TinyChipHub/bitaxe/(commit log)

2024-06-21 *Move barrel jack to fix the enclosure; *Add logo
    [bitaxeSupra-B_Cu.gbr, bitaxeSupra-B_Mask.gbr, bitaxeSupra-B_Paste.gbr, bitaxeSupra-B_Silkscreen.gbr, bitaxeSupra-Edge_Cuts.gbr, bitaxeSupra-F_Cu.gbr, bitaxeSupra-F_Mask.gbr, bitaxeSupra-F_Paste.gbr]
2024-07-15 Add TCH logo
    [bitaxeUltra-B_Cu.gbr, bitaxeUltra-B_Mask.gbr, bitaxeUltra-B_Paste.gbr, bitaxeUltra-B_Silkscreen.gbr, bitaxeUltra-Edge_Cuts.gbr, bitaxeUltra-F_Cu.gbr, bitaxeUltra-F_Mask.gbr, bitaxeUltra-F_Paste.gbr]
2026-01-25 Change logo for to B
    [bitaxeUltra-B_Cu.gbr, bitaxeUltra-B_Mask.gbr, bitaxeUltra-B_Paste.gbr, bitaxeUltra-B_Silkscreen.gbr, bitaxeUltra-Edge_Cuts.gbr, bitaxeUltra-F_Cu.gbr, bitaxeUltra-F_Mask.gbr, bitaxeUltra-F_Paste.gbr]
